nananek/waveshare-genshin-midi-keyboard/hardware/rp2350_frisk/docs/placement.png

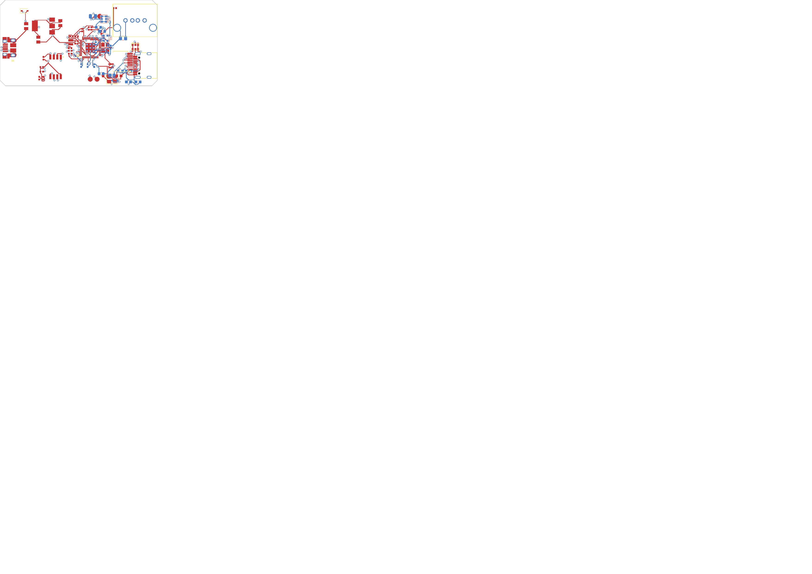
hardware/rp2350_frisk/docs/placement.png
