nananek/waveshare-genshin-midi-keyboard/hardware/rp2350_zero_carrier/jlc_bom.csv

Comment | Designator | Footprint | LCSC Part #
TPS2553DBVR | U1 | TPS2553DBVR | C55266
1uF X7R 16V | C1 | C_0603 | C93816
52.3k 1% | R3 | R_0603 | C23198
100k 1% | R4,R5 | R_0603 | C14675
100nF X7R 50V | C3 | C_0603 | C14663
