nananek/waveshare-genshin-midi-keyboard/hardware/rp2350_zero_carrier/bom.csv

Reference | Qty | Value | Footprint(assigned) | 秋月候補(型番/通販コード) | 備考
J1/J3（組立方向） | 2 | 組立必須注記 | RP2350-Zero用ピンソケット | 該当なし | メスソケットはキャリアのF.Cu（表面）へ実装する。RP2350-ZeroのUSB-C/BOOT/RUN/LEDがある部品面はキャリアから外側（上）に向ける。USB-C/BOOT側をソケット外側の矢印側（+Y・横5穴列の反対端）に合わせること。部品面をキャリア側へ向ける裏返し実装は禁止（穴が合って見えても電気的に鏡映される）。
J1/J3（Zero側オス・組立方向） | 2 | 組立必須注記 | RP2350-Zero本体 | 該当なし | Zero側のオスピンは部品面と反対側（ピン側）からキャリアの表面ソケットへ挿す。半田付け前に、USB-C/BOOT/RUNが矢印側にあり、BOOT/RUNとLEDが外側から見えることを確認する。
J1/J3 | 2 | RP2350-Zero用ピンソケット(23pin=GPIO20+電源3、2026-08-22訂正版) | rp2350_zero_carrier:RP2350_Zero_Header_23p | 分割ロングピンソケット FHU-1x42SG / 通販コード105779(1×42、¥80税込) ×2個 | 2026-08-22訂正: 旧候補103077(FH-1×20)は分割不可の固定1×20と判明し、今回の用途(モジュール1個につき9pin+9pin+5pin=23pinを必要な長さに切って使う)に合わないため105779へ差し替え。105779は単列42pinで秋月商品ページに「カットのために1列を犠牲にすることもありません」=任意の長さに自由にカット可と明記(2026-08-22 WebFetchで確認)。2個で84pin確保、必要数46pin(23pin×2モジュール)に対し十分な余裕。価格¥80(税込)・在庫豊富(43009個、2026-08-22確認)。Waveshare公式wiki寸法図+SwitchScienceピン配置図の2つの独立公式画像で相互確認。左辺9pin(5V/GND/3V3/GP29/28/27/26/GP15/14)、右辺9pin(GP0-8)、下辺5pin(GP13/12/11/10/9)のidentity/orderを2026-08-29にWaveshare公式pinout画像と照合済み。ピッチ2.54mm・列間15.24mm・穴径1.0mm/パッド径1.6mm。原点=モジュール中心、USB-C/BOOT-RUN側を+Yに向けて実装。J1のGP4とJ3のGP5をUART_MIRROR netで基板内直結(GNDは共通netで自動的に接続)
J1/J3(Zero側オス) | 2 | RP2350-Zero用ピンヘッダー(23pin=GPIO20+電源3を必要な長さに切って使用) | (RP2350-Zero本体にはんだ付け。基板側フットプリントなし) | ピンヘッダー(オス) PH-1x40SG / 通販コード100167(1×40、¥35税込) ×2個 | 2026-08-22訂正: 旧候補100078(PH-2×10SG)は秋月商品ページで「2列を1列ずつ折って使用できる」との記載のみで、1列内での任意長カット(ブレイクアウェイ)への言及が無いため、105779と同じ用途(9pin+9pin+5pinに切って使う)には確証不足と判断。任意長カットを明記した単列品100167に差し替え(秋月商品ページに「ニッパなどでカットすれば任意の長さにして使用できます」と明記、2026-08-22 WebFetchで確認)。2個で80pin確保、必要数46pin(23pin×2モジュール)に対し十分な余裕。価格¥35(税込)・在庫8000個(2026-08-22確認)。RP2350-Zeroがヘッダー同梱の場合は購入不要な可能性あり要確認。J1・J3の2モジュール分必要
J2 | 1 | USB-Aメスコネクタ(基板取付・スルーホール) | rp2350_zero_carrier:USB_A_Neltron_5075AR-04-WH | Neltron 5075AR-04-WH / 通販コード 100160 | 実図面ベースでカスタムfootprint作成済み(信号ピン⌀0.92mm丸穴×4・ピッチ2.50/2.00/2.50mm、シェル固定ペグ⌀2.3mm×2・間隔13.14mm・信号ピン列から2.70mmオフセット)。2026-08-22確認: ¥50(税込)・在庫7205点(在庫豊富)
R1 | 1 | 22Ω(USB D+直列抵抗) | rp2350_zero_carrier:R_Axial_THT_P10.16mm | 秋月扱い汎用THT抵抗(型番問わず) | 1/4W級で可。J1側は**GP12に戻した**(GP14案は誤りだったため取消、旧基板デフォルトと同じ)。footprintはKiCad標準ライブラリ名から自作品に差し替え(ピッチ10.16mm、丸パッド1.6mm/ドリル0.8mm、要現物確認)。2026-08-22再確認: rp2350_zero_carrier.kicad_schでR1のpin1/2に付くラベルはGP12_USB_DPとUSB_A_DPのみで、J3側(GP12/GP13相当)にはUSB_DP/USB_DM系のラベルが一切存在しない(J3はUSB-Aホストを持たない設計、§3.1)ことを確認済み。R1/R2を各1個(計2個・J1側のみ)使用する
R2 | 1 | 22Ω(USB D-直列抵抗) | rp2350_zero_carrier:R_Axial_THT_P10.16mm_notopsilk | 秋月扱い汎用THT抵抗(型番問わず) | 1/4W級で可。J1側は**GP13に戻した**(GP15案は誤りだったため取消、旧基板デフォルトと同じ)。U1/C1との物理干渉を避けるためR2だけはB.Cu側へ寝かせて挿入しF.Cu側から半田付けする。B.SilkscreenのR2 referenceと抵抗本体の外形が見える側が実装面。2026-08-22再確認: R2はGP13_USB_DM/USB_A_DMのみに接続、J3側に相当ネットなし(R1と同じ理由)
F1 | 1 | リセッタブルヒューズ(PTC・ラジアルリード) | rp2350_zero_carrier:Fuse_Bourns_MF-R050_Radial | Bourns MF-R050 / 通販コード 112628 | 型番確定(前回計画書の「MF-R050相当」から確定)。実データシートベースでカスタムfootprint作成済み(ピッチ5.1mm・リード径⌀0.51mm→ドリル0.8mm丸穴)。USB-A電源経路はJ1 5V→F1→U1→SW4→C2/J2。2026-08-22確認: ¥30(税込)・在庫12285点(在庫豊富)
U1 | 1 | TPS2553DBVR(電流制限付きハイサイドUSBパワースイッチ) | rp2350_zero_carrier:TPS2553DBVR | Texas Instruments TPS2553DBVR / JLC C55266 | EN(pin3)はJ1 pad23=GP9(USB_PWR_EN)で制御しR5=100kΩでGNDへpull-downするためboot default off。FAULT(pin4)はJ1 pad22=GP10へ接続しR4=100kΩで3V3へpull-up。TPS2553DBVR-1および代替品は禁止
C1 | 1 | 1uF X7R 16V 0603 | rp2350_zero_carrier:C_0603 | FH 0603B105K160NT / JLC C93816 | TI推奨の入力バイパス0.1uF以上を満たす。U1のIN/GND直近へ実装
R3 | 1 | 52.3kΩ 1% 0603 | rp2350_zero_carrier:R_0603 | UNI-ROYAL 0603WAF5232T5E / JLC C23198 | TI Rev.F Table 2の500mA行: ideal 52.5kΩ・closest 1% 52.3kΩ・actual min/nom/max 448.3/501.6/562.4mA。これは短絡保護上限であり接続機器へ500mAを保証する値ではない
R4 | 1 | 100kΩ 1% 0603 | rp2350_zero_carrier:R_0603 | YAGEO RC0603FR-07100KL / JLC C14675 | TPS2553のオープンドレインFAULTを3V3へプルアップ。USB_PWR_FAULT_NはJ1 pad22=GP10へ接続
R5 | 1 | 100kΩ 1% 0603 | rp2350_zero_carrier:R_0603 | YAGEO RC0603FR-07100KL / JLC C14675 | TPS2553 ENをGNDへプルダウンしboot/reset中のUSB-A VBUSを確実にOFF。J1 pad23=GP9が列挙完了後にのみHigh駆動
C3 | 1 | 100nF X7R 50V 0603 | rp2350_zero_carrier:C_0603 | YAGEO CC0603KRX7R9BB104 / JLC C14663 | TPS2553 OUT-GND直近の高周波バイパス。既存C2=220uFはSW4後段のバルク容量として維持
TP_EN/TP_FAULT/TP_IN/TP_OUT/TP_GND | 5 | 1.5mm SMD test pad | rp2350_zero_carrier:TestPad_1.5mm | 実装部品なし | EN/FAULT/VBUS_TPS_IN/VBUS_USB_A/GNDの受入測定点。board_only・BOM/CPL除外・ペーストなし
C2 | 1 | 220uF 16V 電解コンデンサ | rp2350_zero_carrier:CP_Radial_D6.3mm_P2.50mm | Rubycon 16PX220MEFC6.3X11 / 秋月通販コード110326 | USB下流ポートのバルク容量。直径6.3mm・リードピッチ2.5mm。pad1(+)をVBUS_USB_A_SWへpad2(-)をGNDへ接続するため極性を厳守。TIのUSB用途例にある120uF以上を満たす
SW1 | 1 | 1回路2接点スイッチ(3ピン)をON-OFF用途で使用(ミュート用) | rp2350_zero_carrier:SW_SPDT_NKK_115643_Slide | NKKスイッチズ / 通販コード 115643 | 訂正:秋月に基板用SPST(2pin)は無く3pin(1回路2接点)品を使用。中央コモンをGP28へ、片側接点をGNDへ、残り1接点はNC。端子が平角(0.6×0.4mm)のため角形パッドのカスタムfootprint作成済み。2026-08-22確認: ¥110(税込)・在庫2969点(在庫豊富)。SW1〜SW5で計5個必要、全て同一部品(SS-12SDP2)
SW2 | 1 | 1回路2接点スイッチ(3ピン)をON-OFF用途で使用(フィルター用) | rp2350_zero_carrier:SW_SPDT_NKK_115643_Slide | NKKスイッチズ / 通販コード 115643 | 同上。中央コモンをGP29へ、片側接点をGNDへ、残り1接点はNC。価格・在庫はSW1参照(¥110税込・在庫2969点)
SW3 | 1 | 1回路2接点スイッチ(3ピン)をON-OFF用途で使用(予備) | rp2350_zero_carrier:SW_SPDT_NKK_115643_Slide | NKKスイッチズ / 通販コード 115643 | 中央コモンをGP27へ片側接点をGNDへ残り1接点はNC。今回の電源制御には流用せずファームも未対応のまま維持
SW4 | 1 | 1回路2接点スイッチ(3ピン)をON-OFF用途で使用(USB-A VBUS手動遮断) | rp2350_zero_carrier:SW_SPDT_NKK_115643_Slide | NKKスイッチズ / 通販コード 115643 | GPIOには接続しない純粋な電源経路スイッチ。RP2350-Zeroの5V→F1→U1(TPS2553)→SW4→C2/J2(USB-A)pin1(VBUS)の直列経路を維持。外部電源入力やSW3流用は追加しない
SW5 | 1 | 1回路2接点スイッチ(3ピン)をON-OFF用途で使用(J3=ボード2のサステインスイッチ、issue #8) | rp2350_zero_carrier:SW_SPDT_NKK_115643_Slide | NKKスイッチズ / 通販コード 115643 | 新規追加(2026-08-21)。SW1-4と同一部品。中央コモンをJ3のGP29(GP29_SW5_SUSTAIN net)へ、片側接点をGNDへ、残り1接点はNC。ファーム側はserial_midi_device/sustain_switch.c(PR #9)で対応済み。価格・在庫はSW1参照
SW6 | 1 | タクトスイッチ4pin(J3=ボード2のMIDI RESETボタン、issue #6) | rp2350_zero_carrier:SW_TACT_Akizuki_DTS63 | 秋月電子 DTS-63-N-V-BLK(黒) / 通販コード 103647 | 新規追加(2026-08-21)。実データシートベースでカスタムfootprint作成済み(4本足⌀1.0mm丸穴、6.50mm(横)×4.50mm(縦)の長方形配置、本体6.2×6.2mm高さ7mm)。内部結線の解釈違いを避けるため4本とも使用: 片側2本(pad1/2)をGNDへ束ね、反対側2本(pad3/4)をJ3のGP28(GP28_SW6_RESET net)へ束ねる。ファーム側はserial_midi_device/reset_button.c(PR #9)で対応済み。2026-08-22確認: ¥15(税込)・在庫39440点(在庫豊富)
