nananek/waveshare-genshin-midi-keyboard/hardware/rp2350_frisk/fab/bom_full.csv

Designator | Value | Footprint | LCSC | Layer
C1 | 10u | generic_capc2012x125 | C15850 | Top
C2 | 100n | generic_capc1005x50 | C307331 | Top
C3 | 15p | generic_capc1005x50 | C1548 | Bottom
C4 | 15p | generic_capc1005x50 | C1548 | Bottom
C5 | 10u | generic_capc2012x125 | C15850 | Top
C6 | 4.7u | generic_capc1005x50_wide | C23733 | Top
C7 | 4.7u | generic_capc1005x50_wide | C23733 | Top
C8 | 100n | generic_capc1005x50 | C307331 | Bottom
C9 | 4.7u | generic_capc1005x50 | C23733 | Top
C10 | 100n | generic_capc1005x50 | C307331 | Bottom
C11 | 100n | generic_capc1005x50 | C307331 | Top
C12 | 100n | generic_capc1005x50 | C307331 | Top
C13 | 100n | generic_capc1005x50 | C307331 | Bottom
C14 | 100n | generic_capc1005x50 | C307331 | Top
C15 | 100n | generic_capc1005x50 | C307331 | Bottom
C16 | 100n | generic_capc1005x50 | C307331 | Top
C17 | 100n | generic_capc1005x50 | C307331 | Top
C18 | 100n | generic_capc1005x50 | C307331 | Bottom
C19 | 10u | generic_capc2012x125 | C15850 | Top
C20 | 100nF | C_0603_1608Metric | C14663 | Bottom
C21 | 100nF | C_0603_1608Metric | C14663 | Bottom
C22 | 100nF | C_0603_1608Metric | C14663 | Bottom
C23 | 100nF | C_0603_1608Metric | C14663 | Bottom
C24 | 10uF | C_0805_2012Metric | C15850 | Bottom
C25 | 10uF | C_0805_2012Metric | C15850 | Bottom
C26 | 22pF | C_0603_1608Metric | C1653 | Top
C27 | 22pF | C_0603_1608Metric | C1653 | Top
D1 | BAT54WS | D_SOD-323 | C22629 | Top
D2 | BAT54WS | D_SOD-323 | C22629 | Bottom
J1 | 10103594-0001LF | amphenol_10103594-0001lf | TBD | Top
J2 | USB-A HOST | USB_A_Neltron_5075AR-04-WH | TBD | Top
J3 | TYPE-C-31-M-12 | USB_C_Receptacle_HRO_TYPE-C-31-M-12 | C165948 | Top
L1 | 3.3u | abracon_aota-b201610s3r3-101-t | C98336 | Top
R1 | 10k | generic_resc1005x35 | C25744 | Top
R2 | 1k | generic_resc1005x35 | C11702 | Bottom
R3 | 33 | generic_resc1005x35 | C25105 | Top
R4 | 1k | generic_resc1005x35 | C11702 | Top
R6 | 1k | generic_resc1005x35 | C11702 | Top
R7 | 27 | generic_resc1005x35 | C25100 | Top
R8 | 27 | generic_resc1005x35 | C25100 | Top
R9 | 0 | generic_resc1005x35 | C17168 | Top
R10 | 0 | generic_resc1005x35 | C17168 | Top
R13 | 5.1k | R_0603_1608Metric | C23186 | Bottom
R14 | 5.1k | R_0603_1608Metric | C23186 | Bottom
R15 | 22R | R_0603_1608Metric | C23345 | Bottom
R16 | 22R | R_0603_1608Metric | C23345 | Bottom
U1 | RP2350A | rpi_rp2350a_vias | C42411118 | Top
U2 | NCP1117ST33T3G | onsemi_ncp1117st33t3g | C26537 | Top
U3 | W25Q128JVSIQ | generic_soic127p790x195-8 | C97521 | Top
U4 | CH345T | SSOP-20_5.3x7.2mm_P0.65mm | C5246448 | Top
U5 | TPS2051BDBVR | SOT23-5_TPS2051 | C24593 | Bottom
U6 | USBLC6-2SC6 | SOT23-6_USBLC6 | C7519 | Bottom
U7 | USBLC6-2SC6 | SOT23-6_USBLC6 | C7519 | Top
X1 | 12MHz | generic_xtalcc320x250x80-4 | C50430 | Top
X2 | 12MHz | Crystal_SMD_3225-4Pin_3.2x2.5mm | C70565 | Top
