nananek/waveshare-genshin-midi-keyboard/hardware/rp2350_frisk/docs/placement.pdf

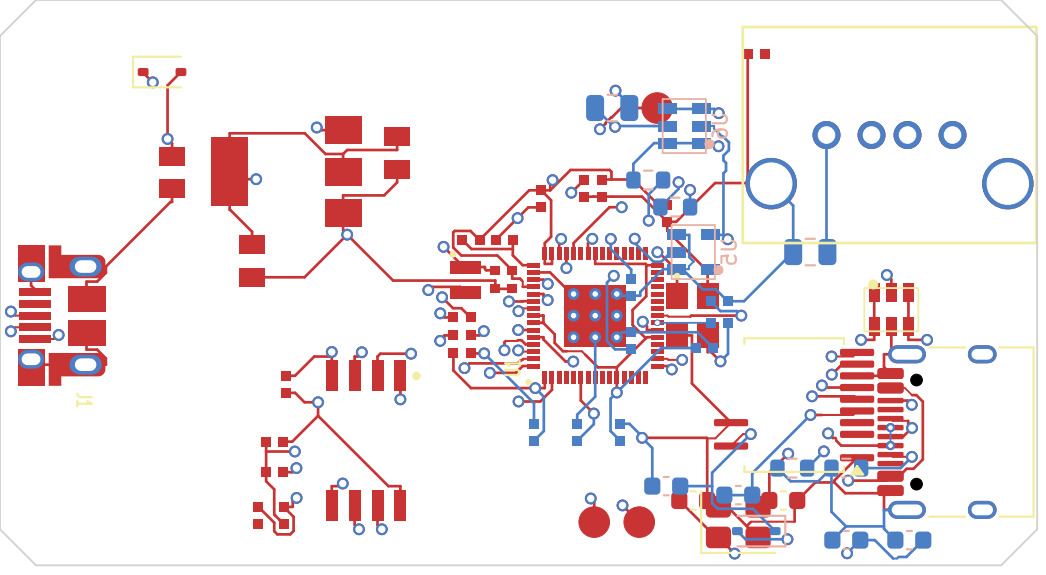
[picture p2: page 1]
