nananek/waveshare-genshin-midi-keyboard/(commit log)

2026-07-14 Initial firmware: RP2350 MIDI keyboard to Genshin HID converter
    USB MIDI キーボードの演奏を RP2350 で解析し、NKRO HID キーボードとして
    PC に送出して原神「諧律のチェンバロ」を弾けるようにするファームウェア。
    - core0: native USB = NKRO HID keyboard device (tud_hid)
    - core1: PIO-USB = USB MIDI host (tuh_midi, idx ベース API)
    - コア間はロックフリーキューで受け渡し、HID 状態は core0 のみが触る
    構成:
    - note_mapper : MIDI ノート -> 21 キースロット変換 (移調 / 範囲外 / 黒鍵ポリシー)
    - midi_parse : 生 MIDI バイト列 -> Note On/Off (running status / realtime / sysex 対応)
    - nkro_repor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
2026-07-14 Fix ARM build: config-descriptor macro typo and rootless Docker uid mapping
    Docker で実ビルドを通して検証した結果の 2 点修正:
    - usb_descriptors.c: TUSB_DESC_CONFIG_ATTR_REMOTE_WAKEUP は誤り。
    正しいマクロ名 TUSB_DESC_CONFIG_ATT_REMOTE_WAKEUP (ATT) に修正。
    - build_docker.sh: rootless docker では container-root が呼び出しユーザに
    マップされるため --user を付けると bind mount に書けなくなる。rootless を
    検出して --user を付け分けるようにした。
    検証: docker (Debian bookworm arm-none-eabi 12.2 + pico-sdk 2.1.1) で
    build/genshin_midi_kbd.uf2 の生成を確認。TinyUSB(0.20.0) の MIDI ホスト
    ドラ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
2026-07-14 docs: README に Docker ビルド手順 (scripts/build_docker.sh) を追記
    検証済みの Docker ビルド経路を 3.A として追加し、ネイティブ
    ツールチェーンビルドを 3.B に整理。
    Claude-Session: https://claude.ai/code/session_01JtkrZWqTSAhUnCwkhXPpRW
2026-08-17 feat(midi-mirror): RAW MIDI を UART1/GP4/31250 へミラー出力
    MIDI キーボードから受信したバイト列 (CIN 除去済みの MIDI 1.0 ストリーム) を
    そのまま別 UART へブロッキング送信する。パース・変換は通さない (フルフィディリティ)。
    - src/midi_mirror.{c,h} 新規: ハード依存層。config.h の MIDI_UART_MIRROR_* で
    有効/無効・ボーレート・UART インスタンス・TX ピンを設定。
    無効時 (MIDI_UART_MIRROR_ENABLE=0) は関数本体ごと #if でコンパイルアウト。
    - midi_host.c: init で midi_mirror_init()、tuh_midi_rx_cb の読出しループで
    tuh_midi_stream_read の返り値を midi_parser_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
2026-08-17 feat(serial-midi-device): UART→USB-MIDI ブリッジ (ボード2) を新規追加
    Waveshare RP2350-USB-A の 2 枚目を、UART RX (31250 8N1) → native USB = USB-MIDI
    クラスデバイスとして使うシングルコア・ファーム。ボード1 の RAW MIDI ミラー
    (UART1 TX=GP4) を UART1 RX=GP5 で受けて PC/DAW へ流す。
    - serial_midi_device/ に独立した 5 ファイル。src/ は include パスに含めない
    (src/tusb_config.h の HID 設定を拾わないため)。
    - tusb_config.h: CFG_TUD_MIDI=1、デバイス専用。CFG_TUH_ENABLED=0。
    - usb_descriptors.c: TUD_MIDI_DESCRIPTOR (標準 MIDI streaming + ジャック)。
    PID 0x4D49 ('M''I') を割り当て (既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
2026-08-17 build(docker): 成果物チェックを 2 本の uf2 対応に更新
    同一ビルドで genshin_midi_kbd.uf2 と serial_midi_device.uf2 の両方が生成される
    ため、build_docker.sh の成果物チェックを両方の uf2/elf を確認するよう変更。
    コンテナ内の cmake コマンドは変更不要 (ルート CMakeLists の add_subdirectory で
    両ターゲットが同一 build ディレクトリにビルドされる)。
2026-08-17 docs: 2 ボード構成 (UART ミラー + シリアル→USB-MIDI) を README/CLAUDE に追記
    - README: §0 に 2 本の uf2 の概要、ソースツリーに midi_mirror/serial_midi_device
    を追記、§4 設定表に MIDI_UART_MIRROR_* とボード2 の config.h を追記、
    §7 に 2 ボード実機配線 (GP4↔GP5 + GND) とミラーの既知のトレードオフを新設。
    - CLAUDE.md: ビルドコマンドを 2 uf2 生成に更新、アーキテクチャに midi_mirror
    (ハード依存層・#if コンパイルアウト) と serial_midi_device (持ち越しバッファ) を
    追記、落とし穴に serial_midi_device の独立 include 空間を追記。
    - .gitignore: worker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
2026-08-17 fix(serial-midi-device): pico_unique_id リンク不足と持ち越しコメントの誤記を修正
    - CMakeLists.txt に pico_unique_id を追加: usb_descriptors.c が呼ぶ
    pico_get_unique_board_id_string は pico_stdlib / tinyusb_device には
    含まれないため、このままだと serial_midi_device.uf2 がリンク失敗する
    (ルートの genshin_midi_kbd は明示的にリンク済み)。
    - main.c の持ち越しコメントを実動作に合わせて修正: 持ち越しが残っている間に
    新データが来た場合は「新しい方を」捨てる。古い方の持ち越しを残すのは
    tud_midi_stream_write のストリーム状態 (途中のパケット) を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
    [main.c]
2026-08-17 fix(serial-midi-device): bNumInterfaces を 2 に修正 + 末尾改行・書式整理
    - usb_descriptors.c: TUD_MIDI_DESCRIPTOR は Audio Control + MIDI Streaming の
    2 インタフェースを生成するため ITF_NUM_TOTAL を 2 に。1 のままでは
    bNumInterfaces が不整合となり列挙に失敗し得る。
    - main.c: boot ログの %u を %d に (既存の PIN ログと書式を統一、int リテラル
    と %u の型不整合を回避)。
    - 新規 7 ファイル (midi_mirror.c/.h, serial_midi_device/*) に末尾改行を追加
    (既存ファイルは全て改行付きで統一されていた)。
    [config.h, main.c, midi_mirror.c, midi_mirror.h, tusb_config.h]
2026-08-17 feat: ミュートスイッチ + 原神鍵盤のみミラーフィルター (#2)
    * fix(build): serial_midi_device の成果物を build/ 直下に出力
    RUNTIME_OUTPUT_DIRECTORY と ARCHIVE_OUTPUT_DIRECTORY を CMAKE_BINARY_DIR に
    設定し、elf/uf2/bin/hex/dis/map を build/serial_midi_device/ ではなく
    build/ 直下に揃える。build_docker.sh の成果物チェック (build 直下) と
    README/CLAUDE.md の記載パスに一致させる。片方だけだと .uf2 が
    ARCHIVE_OUTPUT_DIRECTORY に従うためサブディレクトリに残る。
    * feat(mute): ボード1 にミュートスイッチ (HID 出力のみ無効化、UART ミラーは継続)
    GP28 (LOW アクティブ・内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
    [config.h, hid_mute.c, hid_mute.h, main.c, midi_host.c, midi_mirror.c, midi_mirror.h, midi_note_filter.c]
2026-08-17 fix: ミラーフィルタースイッチ切替時のバイト列破損とバッファ超過を修正
    コミット f9abc49 のコードレビューで見つかった問題への対処:
    - midi_mirror: フィルタースイッチの ON/OFF 切替をメッセージ境界でのみ反映するよう
    ラッチし、メッセージ途中の切替によるバイト列破損を解消。出力バッファも
    ランニングステータス展開 (最大1.5倍) を見込んだ安全なサイズへ拡大し、
    Note Off の黙殺によるキー固着リスクを解消。
    - debounced_switch を新設して hid_mute / mirror_filter_switch の重複デバウンス
    実装を統合。ACTIVE_LEVEL=1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
    [config.h, debounced_switch.c, debounced_switch.h, hid_mute.c, main.c, midi_host.c, midi_mirror.c, midi_mirror.h]
2026-08-18 黒鍵は常にドロップに一本化 (CHROMATIC_SNAP_POLICY を廃止) (#3)
    * refactor: 黒鍵は常にドロップに一本化 (CHROMATIC_SNAP_POLICY を廃止)
    原神の演奏楽器に黒鍵相当が無いため、黒鍵 MIDI ノートを白鍵へスナップする
    DOWN/UP ポリシーを廃止し、常に IGNORE 相当 (黒鍵は NOTE_MAP_NONE) に一本化。
    note_mapper.c を経由する HID 出力・UART ミラーフィルターの両方に効く
    (midi_note_filter.c は note_mapper 依存のためコード変更なしで黒鍵漏れも解消)。
    黒鍵スナップの廃止により、nkro_report のスロット参照カウント (alias) 経路は
    既定ビルド (OUT_OF_RANGE_POLI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
2026-08-19 GitHub Actions でビルド検証 (test/build) + タグ Release 自動作成を追加 (#4)
    * ci: GitHub Actions でビルド検証 (test/build) + タグ Release 自動作成を追加
    push(main)/PR ごとに tests/ のユニットテストと Docker ファームウェアビルドを
    実行し、2つの uf2 を Actions artifact としてアップロードする。v* タグ push
    時は test/build-firmware の成功を前提に GitHub Release を自動作成して
    uf2 をアセット添付する (test/build-firmware/release の3ジョブ構成)。
    action は実装時点の最新メジャー (checkout@v7, upload-artifact@v7,
    download-artifact@v8) を使用。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
2026-08-19 RP2350-Zeroキャリア基板: KiCad回路図(フェーズ2)を追加
    ボード1(MIDI→HIDコンバータ)置き換え用キャリア基板の回路図・BOM・
    プロジェクトファイルを追加。GPIO割り当ては旧基板(RP2350-USB-A)の
    config.h既定値と同一(D+=GP12/D-=GP13/MUTE=GP28/FILTER=GP29)に加え、
    新規の予備スイッチをGP27に割り当て。
    この環境にKiCadが無いためGUIでの動作確認は未実施。回路図はPythonで
    座標・S式を機械生成し括弧対応のみ検証した状態。RP2350-Zeroヘッダーの
    物理ピン配置(pin番号↔GPIO)は未確定のプレースホルダーのため、基板配置
    (workerBが次フェーズ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
    [bom.csv, rp2350_zero_carrier.kicad_sch]
2026-08-19 J2(USB-A)にメーカー実図面ベースのカスタムfootprintを追加
    オーケストレーターがNeltron 5075AR-04-WH(秋月100160)の実図面から取得した
    寸法でfootprintを新規作成。信号ピン4本(⌀0.92mm丸穴、ピッチ2.50/2.00/2.50mm、
    pin1=VBUS/2=D-/3=D+/4=GND)+シェル固定ペグ2本(⌀2.3mm NPTH、間隔13.14mm、
    信号ピン列から2.70mmオフセット)。ローカルfootprintライブラリを解決するため
    プロジェクト直下にfp-lib-tableを追加。
    Claude-Session: https://claude.ai/code/session_01E7QH5gCzZj3tVha83XRuUt
    [bom.csv, rp2350_zero_carrier.kicad_sch]
2026-08-19 F1(リセッタブルヒューズ)にBourns MF-R050の実データシートベースfootprintを追加
    型番を秋月112628(Bourns MF-R050)で確定(前回の「MF-R050相当」から訂正)。
    リード径0.51mm・ピッチ5.1mm(公称)のラジアルリード品として、ドリル0.8mm
    丸穴×2のカスタムfootprintを作成。
    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
    [bom.csv, rp2350_zero_carrier.kicad_sch]
2026-08-19 スイッチをSPST前提から3pin(1回路2接点/SPDT)ON-OFF配線に訂正
    秋月電子には基板用SPST(2pin)スライドスイッチが無く、市販は1回路2接点(SPDT,
    3pin)品のみと判明したため訂正。中央コモンをGPIOへ、片側接点をGNDへ、残り
    1接点はNCとするON-OFF配線に変更。回路図もSwitch:SW_SPDTシンボル(3pin)へ
    差し替え、NKK 115643(通販コード115643)の実図面(端子断面0.6x0.4mm平角、
    2.54mmピッチ)に基づく角形パッドのfootprintを新規作成。
    SW1-3は元のConn_01x02より縦に大きいシンボルになったため、相互干渉を避ける
    ためY方向の配置間隔を10mm→25mmに広げ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
    [bom.csv, rp2350_zero_carrier.kicad_sch]
2026-08-20 feat: unify game mode and add Sumeru lyre mapping
    [rp2350_zero_carrier.kicad_sch]
2026-08-21 gitignore: KiCadの個人環境ファイル(.kicad_prl, .history/)を除外
    KiCadでプロジェクトを開くと自動生成される、プロジェクトローカル設定
    (*.kicad_prl)とローカル履歴バックアップ(.history/, KiCad純正機能)は
    個人環境依存でリポジトリに含める必要がないため除外する。
    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
2026-08-21 kicad_pro: KiCadが開いた際の正規スキーマへの自動更新を反映
    design_settings一式(DRC/ERCルール重大度・zone設定等)・BOM設定・
    tuning_profiles等、KiCad(9系)がプロジェクトを開いて保存した際に
    付与する既定値一式が追加された。手書きで作成した最小限のkicad_proが
    実際にKiCadで開けたことの確認も兼ねる。回路・BOM内容に変更はない。
    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
2026-08-21 USB Host D+/D-をGP12/GP13からGP14/GP15へ訂正
    実機のRP2350-Zeroピンヘッダー配置表により、GP12/GP13は20pinヘッダーに
    物理的に存在しない(はんだ付け専用パッドのみ)と判明したため訂正。
    唯一2本だけの独立列で隣接ペア要件も満たすGP14(D+)/GP15(D-)に変更。
    J1のプレースホルダーpin番号を1/2→10/11(表内の実ピン番号に対応)へ、
    GP27/28/29用も5/6/7→13/14/15へ付け替え。R1/R2は結線ラベルの変更のみ
    (定数変更なし)。
    ファームウェア側の対応(PIN_USB_HOST_DP を 12→14 に変更)は別タスク。
    Claude-Session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
    [bom.csv, rp2350_zero_carrier.kicad_sch]
2026-08-21 J1にユーザー確定のRP2350-Zero実ピン配置footprintを追加
    外形18.0x23.5mm・ピッチ2.54mm・列間15.24mm(600mil)・穴径1.0mm/パッド径
    1.6mmの実測ピン配置表(2026-08-20確定)に基づくカスタムfootprintを作成。
    原点=モジュール中心。pin10/11(GP14/GP15)はUSB D+/D-用の独立2pin列。
    標準ライブラリの汎用1x20 footprintから差し替え。
    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
    [bom.csv, rp2350_zero_carrier.kicad_sch]
2026-08-21 R1/R2のfootprintをKiCad標準ライブラリ参照から自作品に差し替え
    標準ライブラリ 'Resistor_THT:R_Axial_DIN0207_...' は実際のパッド形状を
    この環境で確認する手段がないため、他の自作footprintと同様に丸パッド
    (1.6mm/ドリル0.8mm・ピッチ10.16mm)のカスタムfootprintに統一した。
    電気的な変更はない。
    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
    [bom.csv, rp2350_zero_carrier.kicad_sch]
2026-08-21 フェーズ3: 部品配置(.kicad_pcb)を追加、配線(ルーティング)は未実施
    J1(RP2350-Zeroソケット)をユーザー確定のピン配置通り原点(0,0)に配置。
    USB-A(J2)・R1/R2(直列抵抗)・F1(ヒューズ)・SW1-3(スイッチ)を重なりの
    無い位置に仮配置(座標は簡易チェックスクリプトでbounding box重なり無し
    を確認済み)。基板外形は全部品を包含する矩形(-27,-66)-(36,24) mm。
    各footprintのパッド-ネット対応は回路図(§3のネット一覧)と一致するよう
    生成しており、ネットごとのパッド数一致も機械チェック済み(GND:5、その他
    各ネット2ずつ)。トレース配線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
    [rp2350_zero_carrier.kicad_pcb]
2026-08-21 J1のfootprintをRP2350-Zero実ピン配置図(訂正版・23pin)に差し替え
    前回作成した20pin版は誤り(GP12/GP13が存在しない前提)だったため削除し、
    Waveshare公式wiki寸法図+SwitchSciencのピン配置図で相互確認した23pin版
    (GPIO20+電源3: 5V/GND/3V3)に差し替え。左辺9pinは公式寸法図で確度高、
    右辺8pin・下辺6pinは標準2.54mmグリッドからの推定(確度中、descrフィールド
    に明記)。GP12/GP13は下辺で隣接(pad19/pad18)。
    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
2026-08-21 D+/D-をGP14/GP15からGP12/GP13へ復元(訂正の取り消し)
    前回のGP14/GP15への変更はユーザーが誤った参考表に基づいて依頼したもので、
    今回の正しいピン配置確認(左9/右8/下6=23pin)によりGP12/GP13が実在し
    下辺で隣接することが判明したため取り消す。USB Host D+/D-はGP12/GP13に
    戻り、旧基板(RP2350-USB-A)のconfig.h既定値と再び一致するため、ファーム
    側のPIN_USB_HOST_DP変更は不要になった。
    J1のネットラベルをfootprint側の新pin番号(pad4/5/6=GP29/28/27、
    pad18/19=GP13/GP12)に合わせて再配置。R1/R2側のラベルもGP12/GP13へ
    リネーム(定数変更なし)。BOM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
    [bom.csv, rp2350_zero_carrier.kicad_sch]
2026-08-21 kicad_pcb: J1のfootprint更新(23pin)と配線をGP12/GP13へ反映、重なり再確認
    J1は引き続き原点(0,0)に固定配置。他部品(R1/R2/F1/J2/SW1-3)の座標は
    変更していない(GP27/28/29がJ1の左辺に移ったことで配線経路の見た目上の
    合理性は下がるが、配線はユーザーがGUIで行うため配置自体の変更は不要と
    判断)。footprint bounding boxの重なり無し、回路図とのネットごとの
    パッド数一致(GND:5、他は各2)を機械チェック済み。
    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
    [rp2350_zero_carrier.kicad_pcb]
2026-08-21 SW4(USB-A VBUS電源スイッチ)を回路図に追加
    RP2350-Zeroの5V -> F1(ヒューズ) -> SW4 -> J2(USB-A)pin1(VBUS) の直列経路に
    SW4を割り込ませた。SW1-3と同じSwitch:SW_SPDTシンボル・footprint
    (SW_SPDT_NKK_115643_Slide)を流用し、中央コモンをF1側(VBUS_USB_A net)、
    片側接点をJ2側(新設のVBUS_USB_A_SW net)に接続、残り1接点はNC。GPIOには
    接続しない純粋な電源スイッチ。GND等の他配線は変更なし。
    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
    [rp2350_zero_carrier.kicad_sch]
2026-08-21 BOM: SW4(USB-A VBUS電源スイッチ)を追加、スイッチ数量3→4
    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
    [bom.csv]
2026-08-21 kicad_pcb: SW4を配置、基板外形を拡張
    SW1-3の並び(x=25、15mm間隔)に揃えてSW4をy=30に追加。他部品との重なりを
    確認するため、J2(USB-A)pin1のネットをVBUS_USB_A_SW(SW4経由)に更新。
    SW4が既存の基板外形(-27,-66)-(36,24)からはみ出すため、上辺をy=40まで
    拡張した((-27,-66)-(36,40))。footprint重なり無し・ネットごとのパッド数
    一致(全11ネット)を機械チェック済み。
    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
    [rp2350_zero_carrier.kicad_pcb]
2026-08-21 gitignore: KiCadのロックファイル(*.lck)を除外
    ユーザーがKiCadでプロジェクトを開いている間に生成される一時ロック
    ファイルを追加除外(既存の.kicad_prl/.history/と同種の個人環境ファイル)。
    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
2026-08-21 kicad_pcb: SW4をJ2(USB-A)のすぐ脇へ再配置、基板外形を24mmへ縮小
    SW1-3の並び(x=25)から外し、J2の右脇(20,-55)へ移動(電源スイッチを
    USB端子の近くに置く方が直感的というユーザー意図)。SW4がy=30にあった
    ことで拡張していた基板外形の上辺は、移動後は不要になったため
    (-27,-66)-(36,40)から元の(-27,-66)-(36,24)へ縮小した。footprint重なり
    無し・全11ネットのパッド数一致(GND:5、他各2)を再確認済み。J2とSW4の
    シルク間隔は約5mm。
    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
    [rp2350_zero_carrier.kicad_pcb]
2026-08-21 J3(2個目のRP2350-Zero、ボード2役割)を回路図に追加
    serial_midi_device(UARTミラー→USB-MIDIブリッジ)を別基板ではなく同一
    PCB上の2個目のRP2350-Zeroソケットとして同居させる。J3はJ1と全く同じ
    footprint(RP2350_Zero_Header_23p)・ピン配置表を再利用。
    J1のGP4(UART1 TX、既存ミラー出力)とJ3のGP5(UART1 RX、serial_midi_device
    既定ピン)を新規ネット UART_MIRROR で基板内直結。GNDは既存の共通GND netに
    J3のpin2を追加するだけで足りる(README §7の「GP4->GP5、GND->GND」のうち
    GND分は既存の共有netで自動的に満たされる)。J3はUSB-Aホストもスイッチも
    持たず、5V/3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
    [rp2350_zero_carrier.kicad_sch]
2026-08-21 BOM: J3追加に伴いピンソケット/ピンヘッダの数量を2個分に更新
    RP2350-Zero用ピンソケット・ピンヘッダーはJ1/J3で同一品のため新規調達
    品目は増えない。数量のみ1→2に更新し、行の対象をJ1/J3両方に変更。
    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
    [bom.csv]
2026-08-21 kicad_pcb: J3を配置、基板外形を拡張
    J3(2個目のRP2350-Zero、ボード2役割)を(60,30)に配置。SW1-4やJ1から
    十分な間隔(18.9mm以上)を確保し、他部品と重ならない。J3の+Y側
    (USB-C/BOOT-RUNボタン側)は基板のその方向に他部品が一切無いため、
    外形拡張後の新しい辺(y=50)付近でケーブル挿入の妨げにならない配置。
    基板外形を(-27,-66)-(36,24)から(-27,-66)-(78,50)へ拡張。
    J1のpad14(GP4)ネットをUART_MIRRORに更新(J3のpad15/GP5と接続)。
    footprint重なり無し・全12ネットのパッド数一致(GND:6、他各2)を
    機械チェック済み。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
    [rp2350_zero_carrier.kicad_pcb]
2026-08-21 kicad_pcb: 全部品配置を詰め直し、基板外形を大幅縮小(105x116mm→54.5x49.5mm)
    footprint実寸(silkouline∪パッド外形)を基に部品間クリアランス目安1.5mmで再配置。
    グルーピングはJ1(RP2350-Zero#1)を基準に、USB-A関連(R1/R2/F1/J2/SW4)を直下へ、
    モードスイッチ(SW1-3)を触りやすい東端へ、J3(RP2350-Zero#2)をJ1のUSB-C面を
    塞がない西隣へ集約。基板外形はこの詰めた配置に2.5mmマージンでフィットさせた。
    kicad-cli pcb drc で検証: 新規の重なり違反なし(F1の基準符号がJ2シルクへ
    接近した1件のみ検出、J2/SW4をさらに1.5mm離して解消)。ネットごとの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
    [rp2350_zero_carrier.kicad_pcb]
2026-08-21 kicad_pcb: SWフットプリントのリファレンス符号シルク自己重なりを修正(既存バグ、配置とは無関係)
    kicad-cli pcb drc で今回の詰め直し後に検証したところ、SW1-4(SW_SPDT_NKK_115643_Slide)
    のリファレンス符号テキストが自身のfootprint輪郭線とシルク上で重なる違反が4件残っていた。
    これは配置座標(at)に依らず、footprintの共通配置ルール「基準符号はorigin から Y方向3mm」
    に対し、このfootprintの輪郭ボックス半高が3.25mmしかないため元から(旧配置でも)発生していた
    既存バグと判明(git stashでの再現確認済み)。オフセットを-3mm→-4mm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
    [rp2350_zero_carrier.kicad_pcb]
2026-08-21 feat(board2): MIDI RESETタクトスイッチを追加 (issue #6)
    GP28(内部プルアップ、ボード1のMUTE_SWITCH_PINと同一物理ピン)に接続した
    タクトスイッチの押下エッジごとに MIDI System Reset (0xFF) を1回送信する。
    送信には tud_midi_packet_write() を使う。tud_midi_stream_write() は呼び出しを
    またいで永続する内部状態機械を持ち、UARTパススルー中の未完了メッセージに
    割り込むとバイト列を破壊しうるため(vendored tinyusb midi_device.cで確認)、
    状態機械を経由しない生パケット送信APIに統一した。
    デバウンス本体は src/debounced_switch.c をボード2からも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
    [config.h, main.c, reset_button.c, reset_button.h]
2026-08-21 feat(board2): サステインスイッチ(CC64)を追加 (issue #8)
    GP29(内部プルアップ、ボード1のLYRE_SWITCH_PINと同一物理ピン)に接続した
    スライドスイッチのON/OFF変化ごとに Control Change #64(サステインペダル)を
    127(ON)/0(OFF)で1回だけ送信する。継続送出はしない(受信側がサステイン状態を
    保持するMIDI仕様のため)。送信チャンネルは SUSTAIN_MIDI_CHANNEL で変更可能。
    issue #6と同じ理由(UARTパススルーのバイト列破壊を避けるため)、送信は
    tud_midi_packet_write() を使う。
    Claude-Session: https://claude.ai/code/sessio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
    [config.h, main.c, sustain_switch.c, sustain_switch.h]
2026-08-21 SW5(サステインスイッチ)・SW6(MIDI RESETタクトスイッチ)を回路図に追加、UART0デバッグ用ネットも定義
    - SW5: SW1-4と同一のSW_SPDT_NKK_115643_Slideを再利用。中央コモンをJ3のGP29
    (net GP29_SW5_SUSTAIN)へ、片側接点をGNDへ、残り1接点はNC(issue #8のサステイン
    スイッチ、ファームはPR #9で対応済み)。
    - SW6: 汎用Connector_Generic:Conn_01x04を4pinタクトスイッチの回路図表現として
    流用(内部結線が未確定なため、pin1/2をGND、pin3/4をJ3のGP28(net
    GP28_SW6_RESET)へそれぞれ束ねる防御的配線。issue #6のMIDI RESETボタン、
    ファームはPR #9で対応済み)。
    - U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
    [rp2350_zero_carrier.kicad_sch]
2026-08-21 BOM: SW5(サステインスイッチ)・SW6(タクトスイッチ)を追加
    issue #8用のスライドスイッチ(SW1-4と同一品)と、issue #6用のタクトスイッチ
    (秋月電子 DTS-63-N-V-BLK、通販コード103647)をBOMへ追加。デバッグ用UART0
    テストポイントは指示により部品扱いしないためBOM計上なし(footprintのみ
    pcb側で用意、別コミット)。
    Claude-Session: https://claude.ai/code/session_01AwWZfQU4trNEZXtx5MYHvu
    [bom.csv]
2026-08-21 kicad_pcb: SW5・SW6・UART0テストポイントを配置、基板外形を拡張(56.5x49.5mm→56.5x55.5mm)
    J3(ボード2)のGP28/GP29が空きだった南側の未使用領域(R1列の西・J3の南)へ、
    SW6(タクトスイッチ)→SW5(サステインスイッチ、90°回転せず既存SW1-4と同じ向き)
    →TestPoint(UART0デバッグ用5pad)の順に縦一列で詰めて配置。既存部品との間隔は
    1.2〜2.6mm(目安1〜2mm程度)。基板外形は西側を-31→-33、南側を-35→-41へ拡張
    (いずれも新規部品のシルク+文字ラベルを収めるための最小限の拡張。詳細はコミット
    本文末尾のkicad-cli検証結果を参照)。
    新規footpr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
    [rp2350_zero_carrier.kicad_pcb]
2026-08-21 kicad_pro: デフォルトネットクラスをclearance 0.2→0.15mm, track_width 0.25→0.2mmへ
    配線(ルーティング)自動化の前提として、既定クリアランス/配線幅を少し詰める。
    J1(RP2350-Zeroヘッダー)の底辺6pin(2.54mmピッチ、パッド間隙0.94mm)を通る
    配線経路で、0.2mm幅+0.2mmクリアランス(実効0.6mm)だと1本(GP12_USB_DP、
    R1↔J1)がどうしても収まらなかった。0.2mm幅+0.15mmクリアランス(実効0.5mm)
    なら余裕を持って通る。
    0.15mm/0.2mmはこの基板規模(THTのみ・2層・部品ピッチ2.54mm)では十分に
    安全な値(一般的な格安2層基板の製造能力は0.1〜0.15mm程度までサ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
2026-08-21 kicad_pcb: 配線(ルーティング)を自動生成、全27接続100%完了
    pcbnew(Python)+ Freerouting(オープンソースオートルーター)でこの環境から
    自動配線した。手順:
    1. pcbnew.ExportSpecctraDSN() でSpecctra .dsn形式へ書き出し
    2. Freerouting v2.3.0(ヘッダレス、Java 25ポータブル版で実行)で自動配線
    → .ses ファイル生成
    3. pcbnew.ImportSpecctraSES() で .ses を board へ取り込み、再保存
    結果: 全18ネット・27接続すべて配線完了(ビア0個、F.Cu/B.Cu両面使用、
    最長配線セグメント31.89mm、総配線長663.65mm)。異常な迂回配線は無い
    (最長セグメントもJ3↔TP1間の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
    [rp2350_zero_carrier.kicad_pcb]
2026-08-21 gitignore: KiCadのgerber/drill製造出力を除外
    JLCPCB発注用に kicad-cli pcb export gerbers/drill で生成した
    hardware/*/gerbers/ と *_gerbers_JLCPCB.zip はソースから再生成できる
    ビルド成果物なので、build/ 同様にgit管理対象外にする。
    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
2026-08-21 footprint: RP2350_Zero_Header_23pのピン配置を実機と一致するよう訂正(右辺9・下辺5)
    ユーザーが実物のRP2350-Zeroモジュールのピンを数えたところ、これまでのfootprint
    (左辺9・右辺8・下辺6=計23pin)は右辺・下辺の内訳が誤りで、正しくは左辺9・
    右辺9・下辺5(=計23pin、合計は変わらず)と判明。
    さらにユーザーから、RP2350-Zeroは標準2.54mmピッチのユニバーサル基板にそのまま
    搭載できることを製品として謳っているため、23ピン全てが単一の2.54mmグリッド上に
    乗っているはずだという指摘があった。これに基づき、以前画像から読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
2026-08-21 kicad_pcb: J1/J3のピン配置を訂正版footprintへ更新、全面再配線
    J1・J3(RP2350_Zero_Header_23p)のパッドを、訂正済みfootprint(右辺9pin・
    下辺5pin、前コミット参照)の座標へ合わせて更新した。既存の電気的ネット
    (GP0_UART0_TX/GP1_UART0_RX/UART_MIRROR等、右辺の上寄り8pin)はパッド番号
    不変で位置のみ2.54mm上へシフト。GP12_USB_DP/GP13_USB_DM(下辺、USB D+/D-)
    はパッド番号がずれる(旧pad18/19→新pad19/20)ため、ネット名基準で正しく
    再割当てした。新設のpad18(右辺最下段=GP8)は未使用(NC)。footprint内訳:
    左辺9(pad1-9,変更なし)・右辺9(pad10-18)・下辺5(pad19-23)=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
    [rp2350_zero_carrier.kicad_pcb]
2026-08-21 footprint: 下辺5パッドのY座標を-12.70→-10.16へ訂正(左辺・右辺の最終行と同じ行に)
    PR #11の座標(下辺Y=-12.70、左辺・右辺の最終行Y=-10.16からさらに1グリッド下)
    は、モジュールの実際の物理的な大きさからはみ出す座標であり誤りだった。
    正しくは下辺5本(GP13,12,11,10,9)は左辺・右辺の最終行と**同じY=-10.16**に
    配置し、左辺9本目(GP14, X=-7.62)と右辺9本目(GP8, X=+7.62)の間を埋める形で
    一直線に並ぶ。X座標(-5.08,-2.54,0,+2.54,+5.08)・GPIO割当は変更なし。
    結果として、左辺9・右辺9・下辺5は「2本の縦列+それらの下端を繋ぐ1本の横列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
2026-08-21 kicad_pcb: J1/J3の下辺パッド座標を訂正版footprintへ更新、全面再配線
    J1・J3(RP2350_Zero_Header_23p)の下辺5パッド(pad19-23)をY=-12.70→-10.16へ
    更新(前コミット参照)。X座標・ネット割当(GP13_USB_DM/GP12_USB_DPを含む)は
    パッド番号ごと不変。
    パッド位置が変わったため既存トラックの一部が無効化するため、前々回・前回と
    同じ手順で全面再配線した:
    1. 既存トラック/ビアを全て削除(pcbnew経由)
    2. pcbnew.ExportSpecctraDSN() でSpecctra .dsn書き出し
    3. Freerouting v2.3.0(ヘッドレス)で自動配線 → 27接続全て0 violationで完了
    4. pcbnew.ImportSpecctraSES()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
    [rp2350_zero_carrier.kicad_pcb]
2026-08-21 chore(hardware): キャリア基板BOMのピンソケット/ヘッダ差し替え+価格在庫最新化
    分割不可の固定1x20だったピンソケット103077を、任意長カット対応の
    分割ロングピンソケットFHU-1x42SG(105779)に差し替え。ピンヘッダ100078も
    1列内カットの確証が無かったため、任意長カットが明記されたPH-1x40SG(100167)
    に差し替え。あわせてUSB-Aコネクタ/スライドスイッチ/リセッタブルヒューズ/
    タクトスイッチの価格・在庫を最新化し、R1/R2(22Ω)の数量2個がkicad_schの
    ネット定義(J1側のみ)と整合することを再確認した。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
    [bom.csv]
2026-08-21 kicad_pcb: R1・R2(抵抗)・F1(ヒューズ)を2.54mmグリッドに整列、再配線
    R1・R2・F1は手はんだ付け実装(リード線を曲げて任意ピッチ可)なので、標準的な
    2.54mm整数倍のピッチ・位置に揃えた:
    - R1/R2: footprint自体のピッチ(10.16mm=2.54×4)は既にグリッド準拠だったため
    変更なし。配置位置(footprint原点)を(∓11.33,-17.05)→(∓12.70,-17.78)へ移動
    し、両パッドとも絶対座標がグリッド上(2.54mm整数倍)に乗るようにした。
    - F1: 配置位置を(0,-17.05)→(0,-17.78)へ移動。あわせてfootprint自体のパッド
    ピッチを5.10mm→5.08mm(2.54×2)へ微調整(`Fuse_Bourns_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
    [rp2350_zero_carrier.kicad_pcb]
2026-08-21 kicad_pcb: 四隅に取り付け用ネジ穴(NPTH ⌀2.7mm)を追加
    Raspberry Pi的な取り付け穴を4箇所追加(H1-H4、新規footprint
    `MountingHole_NPTH_2.7mm`、非スルーホール・非実装・BOM計上なし)。
    - H1(左上): (-29, 14.5) H2(右上): (19.5, 14.5)
    - H3(左下): (-29, -38) H4(右下): (19.5, -38)
    各穴は基板端から2.5〜4mm内側、既存部品(J1/J2/J3/SW1-6/TP1/R1/R2/F1)から
    1mm以上のクリアランスを確保。右上・左上コーナーはJ3・SW3のシルクが基板北端
    (旧Y=14.5)ぎりぎりまで迫っておりネジ穴の入る余地が無かったため、基板外形の
    北端を14.5→18.5(+4mm)へ拡張して確保した(南端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
    [rp2350_zero_carrier.kicad_pcb]
2026-08-22 kicad_pcb: シルクスクリーンの相互重なりを解消(F1/J2、SW1-3)、再配線
    目視確認とカスタム監査スクリプトで、標準DRC(kicad-cli pcb drc)では
    検出されないシルク同士の重なりを3件発見・修正した:
    - F1(ヒューズ)のリファレンス文字がJ2(USB-A)のシルク枠に約0.1mmはみ出し。
    PR#13でF1をグリッド整列した際にJ2との間隔チェックがF1本体のみで、
    文字オフセット込みの再検証が漏れていたことが原因。J2を0.5mm南へ移動して解消。
    - SW1-SW2、SW2-SW3間で、各スイッチの南向きリファレンス文字(-4mmオフセット)が
    1.5mmしか離れていない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
    [rp2350_zero_carrier.kicad_pcb]
2026-08-22 kicad_pcb: 4隅のネジ穴に1mmキープアウトゾーンを追加、再配線
    左上ネジ穴(H3)の際まで配線が来ている、との指摘を受けて確認。デフォルトDRC
    の穴クリアランスルールは満たしていたが、実運用上の安全マージン(穴縁から
    1mm以上)を切っていた箇所がH3の2セグメントで見つかった(旧クリアランス
    0.541mm、GP0_UART0_TX)。
    H1-H4それぞれに、穴半径(1.35mm)+1.0mmマージン=半径2.35mmの円形キープアウト
    ゾーン(配線・ビア・ゾーン塗り潰し禁止、F.Cu/B.Cu)を追加。Specctra DSN
    エクスポートでkeepout構造として正しく出力されることを確認し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
    [rp2350_zero_carrier.kicad_pcb]
2026-08-22 回路図: UART1逆方向(J3 GP4→J1 GP5)をUART_MIRROR_RETURNとして追加
    現状J1 GP4(UART1 TX)→J3 GP5(UART1 RX)のみ結線(ネットUART_MIRROR)。
    UART1を双方向化するため、逆方向のJ1 GP5(UART1 RX)←J3 GP4(UART1 TX)を
    新規ネットUART_MIRROR_RETURNとして追加した。GP4/GP5とも両基板側で元々
    UART1のTX/RXペアとして存在する既存ピンのため新規シンボルは不要、
    既存のConn_01x20(J1/J3)シンボルの未使用ピンにラベルを追加しただけ。
    ラベル位置は既存のGP0/GP1(UART0デバッグ)・UART_MIRROR(GP4/GP5)ラベルと
    同じ2.54mmピッチの並びに合わせて配置(J1側はGP4ラベルの1つ下、J3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
    [rp2350_zero_carrier.kicad_sch]
2026-08-22 kicad_pcb: UART1逆方向配線(UART_MIRROR_RETURN)を追加、全面再配線
    J1のGP5(pad15)とJ3のGP4(pad14)、いずれも従来ネット未割当だった既存パッドに
    新規ネットUART_MIRROR_RETURNを割り当て、UART1(J1-J3間UARTミラーリンク)を
    双方向化した(既存のUART_MIRROR: J1 GP4→J3 GP5 に加えて、逆方向 J1 GP5←J3
    GP4 を追加)。新規部品は無し、既存footprintのパッドを使うのみ。
    compare_boards.pyで、意図した2パッド(J1 pad15, J3 pad14)のネット割当以外に
    変化が無いことを確認(footprint位置・基板外形は不変)。ネット追加によりパッド
    位置は変わらないが接続関係が変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
    [rp2350_zero_carrier.kicad_pcb]
2026-08-22 footprint: USB-Aシェル固定穴をNPTH→PTHへ変更、GND用パッド化
    実データシートでNeltron 5075AR-04-WHのシェル材質が真鍮・ニッケルメッキ
    (導電性)と確認できたため、シェル固定用の穴2箇所(pin5/6、ドリル2.3mm)を
    NPTH(パッドなし・ネットなし)からPTH(パッド径2.8mm)へ変更した。
    一般的なUSB-A THTコネクタの実装慣習に倣い、この2ピンはGNDへ接続する
    (はんだ付けによる機械的強度向上+簡易シールド接地。本基板は高速差動信号の
    厳密なインピーダンス管理やシャーシ分離が要る設計ではないため、専用の
    アイソレートシャーシネ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
2026-08-22 kicad_pcb: J2シェル固定穴をPTH化してGNDへ接続、全面再配線
    J2(USB-A)のシェル固定用パッド2箇所(pin5/6、footprint側でNPTH→PTH/
    パッド径2.8mmへ変更済み)に既存のGNDネットを割り当てた。新規ネットは
    作らず、他のGND接続パッド(J1/SW1-3/F1等)と同じ既存GNDネットを再利用。
    compare_boards.pyで、意図したJ2の2パッドのネット追加以外に差分が無い
    ことを確認(footprint位置・基板外形は不変)。パッド追加によりGNDネットの
    接続点が増えるため、既存配線を全削除しitem 10-16と同じ手順(DSN書き出し
    →Freeroutingヘッドレス→SES取り込み)で全19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
    [rp2350_zero_carrier.kicad_pcb]
2026-08-25 fix(hardware): add RP2350-Zero socket orientation markers
    [bom.csv, rp2350_zero_carrier.kicad_pcb]
2026-08-25 fix(hardware): correct J2 USB-A shell/signal front-back offset
    The USB_A_Neltron_5075AR-04-WH footprint had the shell
    mounting pegs (pad 5/6, φ2.3) placed 2.70mm north of the
    signal row (pads 1-4, φ0.92), i.e. signal was closer to the
    mating opening. Per the Neltron manufacturing drawing
    (5075AR-04-WH-F1.pdf, Akizuki 100160, 2026-08-19) side view
    (opening->shell 10.30mm, shell->signal 2.70mm) and PCB LAYOUT,
    the shell is 2.70mm CLOSER to the opening than the signal
    pins -- the offset was reversed.
    A 1:1 print test with a real 5075AR-04-WH confirmed the
    reversal: shell and signal rows were swapped front-back.
    - footprint: move shell pads from (at ±6.57 2.7) to (at ±6.57 -2.7)
    (relativ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
    [rp2350_zero_carrier.kicad_pcb]
2026-08-27 ci: attach gerbers and drawings to releases
2026-08-27 fix(ci): limit release Gerbers to fabrication data
2026-08-27 fix(ci): pin and validate KiCad release assets
2026-08-27 fix(ci): set writable KiCad home
2026-08-27 fix(hardware): fit carrier schematic on A4
    [rp2350_zero_carrier.kicad_sch]
2026-08-27 fix(hardware): separate repositioned schematic switches
    [rp2350_zero_carrier.kicad_sch]
2026-08-27 fix(hardware): improve schematic PDF readability
    [rp2350_zero_carrier.kicad_sch]
2026-08-27 fix(hardware): reflow schematic for A3 PDF
    [rp2350_zero_carrier.kicad_sch]
2026-08-28 wip(hardware): add USB VBUS protection circuit
    [rp2350_zero_carrier.kicad_pcb, rp2350_zero_carrier.kicad_sch]
2026-08-28 checkpoint(hardware): refine USB VBUS protection layout
    [rp2350_zero_carrier.kicad_pcb, rp2350_zero_carrier.kicad_sch]
2026-08-28 checkpoint(hardware): document and validate VBUS protection
    [bom.csv, rp2350_zero_carrier.kicad_pcb]
2026-08-28 checkpoint(hardware): align schematic pin mapping with PCB
    [rp2350_zero_carrier.kicad_sch]
2026-08-28 checkpoint(hardware): clarify USB power budget
    [bom.csv]
2026-08-28 build_gerbers: split board layout PDF into per-layer pages
    Use --mode-multipage so F.Cu/B.Cu/F.Silkscreen/B.Silkscreen/
    Edge.Cuts each get their own page in a single PDF (was
    --mode-single compositing all layers onto one page). Release
    artifact path unchanged.
2026-08-28 docs(hardware): add JLC BOM/CPL and document VBUS protection design decisions
    Add jlc_bom.csv/jlc_cpl.csv for the four JLCPCB-assembled SMD parts
    (U1, CIN, R_ILIM, R_FAULT); designators match exactly between the two
    files. LCSC part numbers are included only where directly confirmed on
    LCSC's own product pages (U1, CIN, R_FAULT); R_ILIM's 52.3k 0603 1%
    was not found in LCSC's 0603 catalog and is left blank rather than
    guessed.
    Document the remaining plan-required rationale that wasn't yet in the
    README: TPS2553 (non-latch) part selection, EN direct-tie safety
    margin, R_ILIM value sourcing, VBUS trace width IPC-2221 justification
    (including why the pre-existing J1->F1 0.2mm segment was left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
    [jlc_bom.csv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]
2026-08-28 fix(hardware): move R2 reference designator to the silkscreen layer it's actually printed on
    R2 uses a bottom-assembly footprint (body mounted on B.Cu, soldered from
    F.Cu) so it wouldn't collide with U1/R_ILIM. Its printed reference "R2"
    was left on F.Silkscreen, the side with no body, while B.Silkscreen (the
    side the body is actually on) had no identifying print at all. Move the
    reference (mirrored) to B.Silkscreen so it labels the side a builder
    actually sees the part on; leave the front-side "MOUNT BOTTOM" note in
    place since that's where the pads are and where an assembler needs the
    warning before inserting the leads. Value stays on the unprinted B.Fab
    layer as before (it holds the footp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
    [rp2350_zero_carrier.kicad_pcb]
2026-08-28 feat(hardware): swap every footprint's silkscreen to the opposite layer
    Exchange F.Silkscreen <-> B.Silkscreen for every footprint's reference
    designator, value, outline, and note text across the whole board (user
    instruction). Only the Silkscreen-layer graphics move; pads, Courtyard,
    and Fab layers are untouched, and no footprint is Flip()ped (position,
    rotation, and Cu-layer side are unchanged for every part). Text items
    get their mirror flag toggled to match the new side (front text
    un-mirrored, back text mirrored); non-text outline/arrow graphics keep
    their original coordinates, since the instruction was a layer-only
    swap, not a geometric mirror.
    U1 (TPS2553DBVR) is excluded: it's an SM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
    [rp2350_zero_carrier.kicad_pcb]
2026-08-28 fix(hardware): exclude R2 from the board-wide silkscreen swap
    R2 is a bottom-assembly THT part (body on B.Cu, like U1's SMD-on-F.Cu
    case) and got caught by the previous board-wide F.Silkscreen<->
    B.Silkscreen swap along with every other footprint. That put its
    printed reference designator back on F.Silkscreen -- the side with no
    body -- while B.Silkscreen (the side the body actually occupies) had
    only the "MOUNT BOTTOM" note. Move the reference back to B.Silkscreen
    (mirrored), matching the exclusion already made for U1.
    Also add a printed body-outline rectangle on B.Silkscreen, copied from
    R1's F.Silkscreen/B.Silkscreen outline (same -3.15..3.15 x -1.2..1.2mm
    rectangle, 0.15mm line width).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
    [rp2350_zero_carrier.kicad_pcb]
2026-08-28 fix(hardware): remove R2's redundant "MOUNT BOTTOM" silkscreen note
    Now that R2's reference designator and a real printed body outline
    both live on B.Silkscreen (previous commit), the outline box around
    R2's own pads already marks it as a bottom-assembly part the same way
    R1's outline marks a normal top-assembly one -- an assembler reading
    the silkscreen sees a component footprint with no matching outline on
    the front and a labeled, outlined one on the back, which is self-
    explanatory without extra text (user instruction: the note is no
    longer needed).
    Re-ran ERC/DRC/silk_audit.py plus the Reference/Value-inclusive
    F.Silkscreen+B.Silkscreen overlap audit: counts unchanged (ERC 132,
    DRC 0 vi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
    [rp2350_zero_carrier.kicad_pcb]
2026-08-28 ci: publish JLC assembly files with releases
2026-08-29 fix(hardware): correct U1 (TPS2553DBVR) footprint vertical mirror
    The custom TPS2553DBVR.kicad_mod placed pin1/pin3 (and pin4/pin6) with
    the wrong Y sign, mirroring the whole SOT-23-6 pinout top-to-bottom
    versus the datasheet (SLVS841F) and versus KiCad's own official
    SOT-23-6 footprint (Package_TO_SOT_SMD.pretty, JEDEC MO-178), which
    was used as an independent ground truth: it places pin1 at Y=-0.95
    (top) and pin3 at Y=+0.95 (bottom), the opposite sign from ours.
    Rendering both footprints to SVG confirmed the visual mirror directly.
    Pad numbers/net assignments were already correct (per the earlier
    tps-pinout-plan investigation) -- only the physical Y placement was
    flipped, which is what the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
    [rp2350_zero_carrier.kicad_pcb, rp2350_zero_carrier.kicad_sch]
2026-08-29 fix(hardware): pin R_ILIM to a verified 0603 LCSC part in jlc_bom.csv
    jlc_bom.csv left R_ILIM's LCSC Part # column blank (Comment "52.3k 1%",
    Footprint R_0603), so JLCPCB's own part matching filled the gap on the
    actual order screen and picked C325555 (TyoHM RMC040252.3K1%N) -- an
    **0402** package part, confirmed via JLCPCB's live SMT component API
    (componentSpecificationEn "0402", describe field literally "0402 Chip
    Resistor - Surface Mount"), with stockCount 5 at query time (matches
    the reported 15-unit shortfall). This footprint/package mismatch was
    caught by the user on the JLCPCB ordering screen before fabrication.
    Replaced with C23198 (UNI-ROYAL 0603WAF5232T5E, 52.3kOhm +-1%, 100mW),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
    [jlc_bom.csv]
2026-08-29 fix(hardware): correct U1 placement rotation in jlc_cpl.csv (0 -> 180)
    The footprint's own pin1/mirror bug was already fixed (7a83d68), but
    after re-uploading BOM/CPL the user visually confirmed on JLCPCB's own
    assembly-preview screen that U1 (TPS2553DBVR) is now placed rotated
    180 degrees from the correct orientation. This is a pure rotation
    offset, not a mirror (the footprint geometry itself is already
    correct; only the CPL Rotation column needs adjusting) -- consistent
    with JLCPCB's Pick & Place spec (CPL Rotation column, degrees,
    counter-clockwise positive) documented in the jlcpcb-rotation-check
    investigation.
    That investigation also established there is no official or
    community rotati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
    [jlc_cpl.csv]
2026-08-29 fix(hardware): widen USB VBUS and ground paths
    [rp2350_zero_carrier.kicad_pcb]
2026-08-30 Implement fail-latched USB power redesign
    [bom.csv, jlc_bom.csv, rp2350_zero_carrier.kicad_pcb, rp2350_zero_carrier.kicad_sch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]
2026-08-30 Fix PCB annotations and manufacturing gates
    [bom.csv, jlc_bom.csv, rp2350_zero_carrier.kicad_pcb, rp2350_zero_carrier.kicad_sch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]
2026-08-30 Fix schematic visual audit readability
    [rp2350_zero_carrier.kicad_sch]
2026-08-31 Generate grouped JLC assembly data
    [jlc_bom.csv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]
2026-11-09 feat: pivot to Frisk-size RP2350A + CH9329 MIDI gadget
    Firmware:
    - replace 2-board HID + UART mirror design with one PIO-MIDI gadget
    - native USB is now a USB-MIDI device (raw MIDI passthrough)
    - add CH9329 protocol/6KRO state/non-blocking UART1 output
    - add host tests for CH9329 framing and keyboard state
    Hardware:
    - add hardware/rp2350_frisk: 57.6x31.4 mm, 2 mm corner cuts
    - bare RP2350A QFN-60, W25Q128, 12 MHz crystal, 3.3 V LDO
    - USB-C x2 (MIDI gadget / CH9329 HID) + USB-A host (MIDI keyboard)
    - placement/outline draft, 0 physical DRC errors, routing WIP
    - mark rp2350_zero_carrier as legacy
    Docs/CI:
    - update README/CLAUDE/release notes for the single-UF2 build
    - keep legacy carrier man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
2026-11-09 feat(hardware): finish routed Frisk board and order data
    - route the 57.6x31.4 mm RP2350A + CH9329 board on 4 layers
    - DRC physical errors: 0; remaining unconnected: 3 nets
    - add JLCPCB Gerber/BOM/CPL package under hardware/rp2350_frisk/fab
    - document the 3 hand-solder jumper wires and BOM TBDs
    - note CH9329 9600 vs 115200 baud trade-off and SET-GND procedure
2026-11-09 docs(hardware): reflect routed board and fab artifacts
2026-11-09 feat(ch9329): auto-detect baud via GET_INFO probe
    - add GET_INFO frame builder and response validator
    - probe 115200/57600/38400/19200/9600 at boot and use the first valid reply
    - keep CH9329_UART_BAUD as fallback; CH9329_AUTO_BAUD=0 fixes the rate
    - document that changing CH9329 baud no longer needs a firmware rebuild
2026-11-09 feat: switch to NKRO HID + CH345 and add gadget-side spare switch
    - native USB is NKRO HID again; UART1 31250 feeds CH345 USB-MIDI
    - remove CH9329 protocol/6KRO path and midi_bridge
    - add spare switch on GP27 (moved from old board2 sustain switch)
    - default is state-only; SPARE_SWITCH_CC=64 gives sustain behavior
    - UART writes are mutex-protected between cores
    - update docs and mark the old CH9329 fab package obsolete
2026-11-09 feat(hardware): CH345T 6-layer Frisk board fully routed
    - replace CH9329 with CH345T (SSOP-20) + 12 MHz crystal + ESD
    - rotate RP2350 180 degrees to free QSPI/USB escape
    - 6-layer routing, DRC 0 violations / 0 unconnected
    - regenerate Gerber/BOM/CPL/DRC under hardware/rp2350_frisk/fab
    - move the old sustain switch to GP27/TP5 spare input
    - document via-in-pad at U1 pin22 and J3 A7/B7
2026-11-09 fix(ci): attach Frisk fabrication data to releases
    - add scripts/build_frisk_release.sh to verify the committed Frisk Gerber
    set, repackage it as a deterministic ZIP, and copy BOM/CPL/DRC/order notes
    - add a build-frisk-fab job and attach its assets to the release
    - update release notes and the Frisk README for the v2.0.0 hardware set
2026-11-09 fix(hardware): correct Frisk JLC BOM parts and package sizes
    - replace 0603 C14663/C21190 with 0402 C307331/C11702 where the pads are 0402
    - replace the delisted TPS2051 part C51187 with C24593
    - fill the remaining TBDs from JLC stock: U1-U4, X1/X2, L1, C3/C4, C6/C7/C9,
    C26/C27, R1/R3/R7-R10/R15/R16
    - keep J1/J2 as TBD because JLC has no stock; they are hand-soldered
    - update BOM, order notes, README, CLAUDE and release notes
